benjibst/equilibot/pcb/equilibot.kicad_pcb

## KiCad design pcb/equilibot.kicad_pcb (2025-12-08)

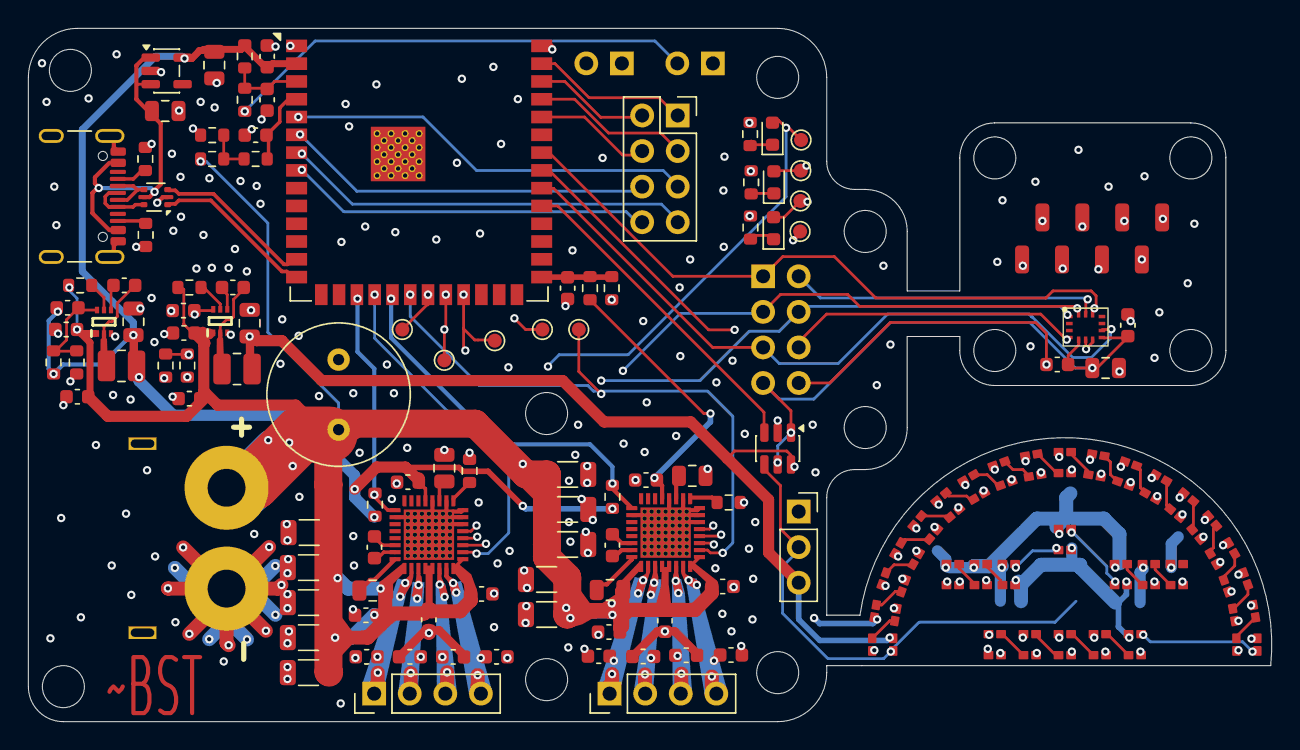
[picture p1: board equilibot.kicad_pcb from above]

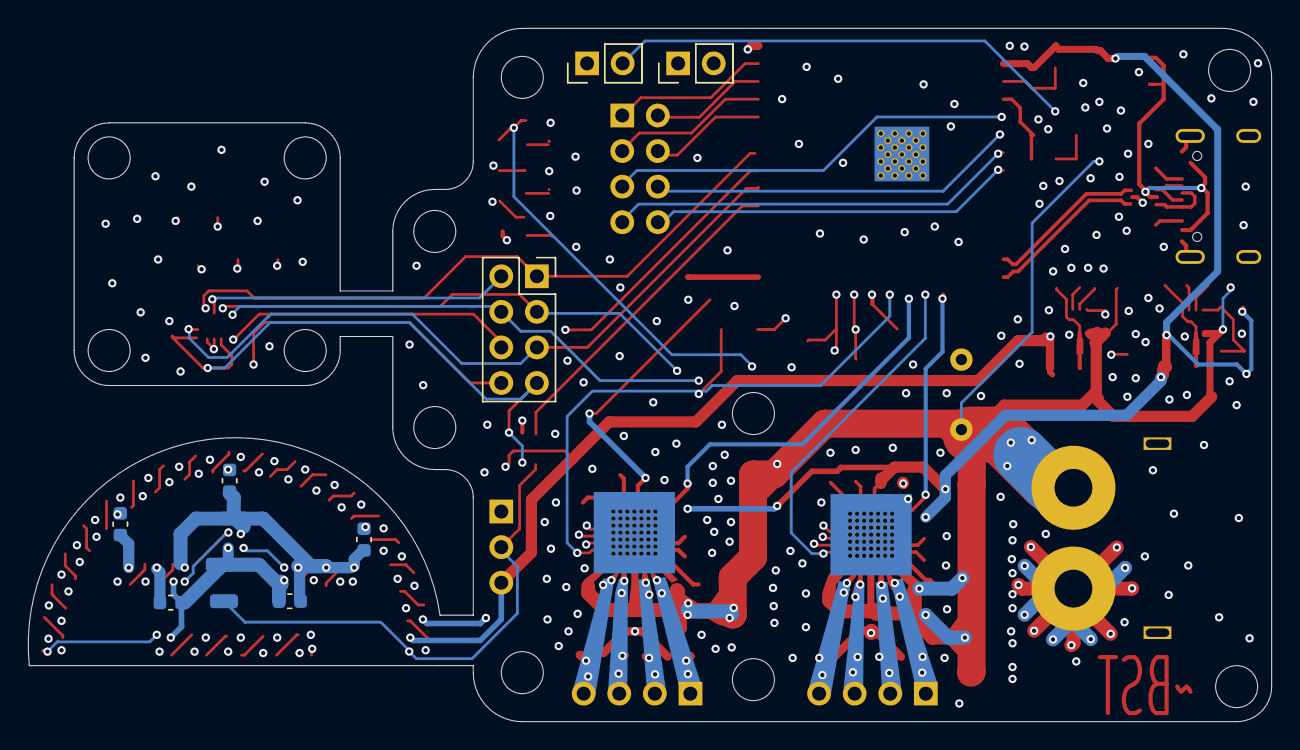
[picture p2: board equilibot.kicad_pcb from below]

Board: 4 copper layers, 88.8 x 49.5 mm, 153 parts (11 on the bottom side), 96 nets.

Parts:
C1, C2, C3, C4, C6, C12, C13, C14, C23, C24, C26, C30, C35, C53, C62, C63: 220n; C_0603_1608Metric
C5, C17, C34, C51, C52: 2.2u; C_0805_2012Metric
C7, C8, C9, C10, C18, C19, C20, C21: 470p; C_0603_1608Metric
C11, C22, C54, C55, C56, C57, C58, C59, C60, C61: 22u; C_1206_3216Metric
C15, C28: 1u; C_0805_2012Metric
C16, C29: 22n; C_0603_1608Metric
C25: 470u; C_Radial_D10.0mm_H16.0mm_P5.00mm
C27, C64: 10u; C_0603_1608Metric
C31, C36: 22u; C_0805_2012Metric
C32, C37, C39, C40, C41, C42, C48: 100n; C_0603_1608Metric
C33, C38: 47p; C_0603_1608Metric
D1, D2, D3, D4, D5, D6, D7, D8, D9, D10, D11, D12, D13, D14, D15, D16, D17, D18, D19, D20, D21, D22, D23, D24, D25, D26, D27, D28, D29, D30, D31: WS2812B; XL_WS2812B_0807
D32, D33, D34: LED_Small; LED_0603_1608Metric
IC1, IC2: TMC5240
IC3, IC4: TPS561243DRLR; SOTFL50P160X60-6N
J1: Conn_01x02_Socket; AMASS_XT60PW-M_1x02_P7.20mm_Horizontal
J2: USB_C_Receptacle_USB2.0_16P; USB_C_Receptacle_GCT_USB4105-xx-A_16P_TopMnt_Horizontal
J3, J4: Conn_01x04_Pin; PinHeader_1x04_P2.54mm_Vertical
J5: Conn_01x03_Pin; PinSocket_1x03_P2.54mm_Vertical
J7, J8: Conn_01x08_Pin; PinSocket_2x04_P2.54mm_Vertical
L1, L2: 3.3u; L_1008_2520Metric
MT1: ICM-42670-P; XDCR_ICM-42670-P
R1, R4: 100; R_0603_1608Metric
R2, R3, R6, R9, R12: 5.6k; R_0603_1608Metric
R5: 12k; R_0603_1608Metric
R7, R11: 3k; R_0603_1608Metric
R8: 10k; R_0603_1608Metric
R10, R16: 13k; R_0603_1608Metric
R13, R17: 100k; R_0603_1608Metric
R14: 135k; R_0603_1608Metric
R15, R19: 30k; R_0603_1608Metric
R18: 220k; R_0603_1608Metric
R20, R21: 5.1k; R_0603_1608Metric
R22: 1k; R_0603_1608Metric
SW1, SW2: SW_Push; PinHeader_1x02_P2.54mm_Vertical
TP1, TP2, TP3, TP4, TP5, TP6, TP7, TP9, TP10: TestPoint; TestPoint_Pad_D1.0mm
TP8, TP11, TP12, TP13, TP14, TP15, TP16, TP17, TP18, TP19, TP20: TestPoint; TestPoint_Pad_1.0x1.0mm
U1: ESP32-S3-WROOM-1
U2: SN74LVC1T45DBV; SOT-23-6
U3: USBLC6-2P6; SOT-666
U4: TLV75533PDBV; SOT-23-5

Connections:
/3V3: C4.2, C5.2, C6.1, C14.2, C26.2, C31.1, C33.2, C52.2, C53.2, D34.2 (A), IC1.5 (VCC_IO), IC2.5 (VCC_IO), J7.7, L1.1, MT1.5 (VDDIO), MT1.8 (VDD), R2.1, R3.1, R9.2, R12.2, R14.2, TP2.1, TP19.1, U1.2 (3V3), U2.1 (VCCA), U2.5 (DIR), U4.5 (OUT)
/5V: C36.1, C38.2, C39.2, C40.2, C41.2, C42.2, C48.2, D1.4 (5V), D2.4 (5V), D3.4 (5V), D4.4 (5V), D5.4 (5V), D6.4 (5V), D7.4 (5V), D8.4 (5V), D9.4 (5V), D10.4 (5V), D11.4 (5V), D12.4 (5V), D13.4 (5V), D14.4 (5V), D15.4 (5V), D16.4 (5V), D17.4 (5V), D18.4 (5V), D19.4 (5V), D20.4 (5V), D21.4 (5V), D22.4 (5V), D23.4 (5V), D24.4 (5V), D25.4 (5V), D26.4 (5V), D27.4 (5V), D28.4 (5V), D29.4 (5V), D30.4 (5V), D31.4 (5V), D33.2 (A), J5.3, L2.1, R18.2, TP3.1, TP11.1, U2.6 (VCCB)
/BAT_MON: C3.2, R6.2, U1.4 (IO4)
/IMU_INT1: J7.6, MT1.4 (INT1/INT), TP18.1, U1.33 (IO40)
/IMU_INT2: J7.5, MT1.9 (INT2), TP17.1, U1.32 (IO39)
/IO5: J8.5, U1.5 (IO5)
/IO6: J8.6, U1.6 (IO6)
/IO7: J8.7, U1.7 (IO7)
/IO15: J8.8, U1.8 (IO15)
/LED_DIN: U1.31 (IO38), U2.3 (A)
/SPI_CS_IMU: J7.1, MT1.12 (AP_CS), TP12.1, U1.34 (IO41)
/SPI_CS_STP1: IC2.26 (CSN/AD2), TP10.1, U1.20 (IO12)
/SPI_CS_STP2: IC1.26 (CSN/AD2), TP9.1, U1.18 (IO10)
/SPI_MISO: IC1.29 (SDO/NAO), IC2.29 (SDO/NAO), J7.4, MT1.1 (AP_SDO/AP_AD0), TP6.1, TP15.1, U1.21 (IO13)
/SPI_MOSI: IC1.28 (SDI/AD0), IC2.28 (SDI/AD0), J7.3, MT1.14 (AP_SDA/AP_SDIO/AP_SDI), TP5.1, TP14.1, U1.22 (IO14)
/SPI_SCLK: IC1.27 (SCK/AD1), IC2.27 (SCK/AD1), J7.2, MT1.13 (AP_SCL/AP_SCLK), TP4.1, TP13.1, U1.23 (IO21)
/STP1_DRV_EN: IC2.9 (DRV_ENN), R12.1, U1.19 (IO11)
/STP2_DRV_EN: IC1.9 (DRV_ENN), R9.1, U1.17 (IO9)
/USB_N: U1.13 (USB_D-), U3.3 (I/O2)
/USB_P: U1.14 (USB_D+), U3.1 (I/O1)
/VM: C11.1, C12.2, C13.2, C15.2, C22.1, C23.2, C24.2, C25.1, C27.1, C28.2, C30.2, C35.2, C54.1, C55.1, C56.1, C57.1, C58.1, C59.1, C60.1, C61.1, C62.2, C63.2, C64.1, D32.2 (A), IC1.17 (VS), IC1.20 (VS), IC1.21 (VS), IC1.24 (VS), IC1.25 (SLEEPN), IC2.17 (VS), IC2.20 (VS), IC2.21 (VS), IC2.24 (VS), IC2.25 (SLEEPN), IC3.1 (VIN), IC4.1 (VIN), J1.2, R5.2, R13.2, R17.2, TP1.1
/leds/DIN_5V: D1.3 (DIN), J5.2, TP16.1, U2.4 (B)
/leds/O1: D12.1 (DOUT), D13.3 (DIN)
/leds/O2: D24.1 (DOUT), D25.3 (DIN)
/psu/SW3V3: C32.2, IC3.4 (BST)
/psu/SW5V: C37.2, IC4.4 (BST)
GND: C1.1, C2.1, C3.1, C4.1, C5.1, C6.2, C7.1, C8.2, C9.1, C10.2, C11.2, C12.1, C13.1, C14.1, C17.2, C18.1, C19.2, C20.1, C21.2, C22.2, C23.1, C24.1, C25.2, C26.1, C27.2, C30.1, C31.2, C34.2, C35.1, C36.2, C39.1, C40.1, C41.1, C42.1, C48.1, C51.1, C52.1, C53.1, C54.2, C55.2, C56.2, C57.2, C58.2, C59.2, C60.2, C61.2, C62.1, C63.1, C64.2, D1.2 (GND), D2.2 (GND), D3.2 (GND), D4.2 (GND), D5.2 (GND), D6.2 (GND), D7.2 (GND), D8.2 (GND), D9.2 (GND), D10.2 (GND), D11.2 (GND), D12.2 (GND), D13.2 (GND), D14.2 (GND), D15.2 (GND), D16.2 (GND), D17.2 (GND), D18.2 (GND), D19.2 (GND), D20.2 (GND), D21.2 (GND), D22.2 (GND), D23.2 (GND), D24.2 (GND), D25.2 (GND), D26.2 (GND), D27.2 (GND), D28.2 (GND), D29.2 (GND), D30.2 (GND), D31.2 (GND), IC1.2 (AIN), IC1.4 (AGND), IC1.10 (UART_EN), IC1.30 (CLK), IC1.31 (REFL), IC1.32 (REFR), IC1.33 (EP), IC2.2 (AIN), IC2.4 (AGND), IC2.10 (UART_EN), IC2.30 (CLK), IC2.31 (REFL), IC2.32 (REFR), IC2.33 (EP), IC3.3 (GND), IC4.3 (GND), J1.1, J2.A1 (GND), J2.A12 (GND), J2.B1 (GND), J2.B12 (GND), J2.S1 (SHIELD), J5.1, J7.8, MT1.6 (GND), MT1.7 (FSYNC), R7.1, R8.2, R10.2, R11.2, R15.1, R16.2, R19.1, R20.1, R21.1, R22.2, SW1.1, SW2.1, TP7.1, TP8.1, TP20.1, U1.1 (GND), U1.40 (GND), U1.41 (EP), U2.2 (GND), U3.2 (GND), U4.2 (GND)
unnamed: D1.1 (DOUT), D2.3 (DIN)
unnamed: D2.1 (DOUT), D3.3 (DIN)
unnamed: D3.1 (DOUT), D4.3 (DIN)
unnamed: D4.1 (DOUT), D5.3 (DIN)
unnamed: D5.1 (DOUT), D6.3 (DIN)
unnamed: D6.1 (DOUT), D7.3 (DIN)
unnamed: D7.1 (DOUT), D8.3 (DIN)
unnamed: D8.1 (DOUT), D9.3 (DIN)
unnamed: D9.1 (DOUT), D10.3 (DIN)
unnamed: D10.1 (DOUT), D11.3 (DIN)
unnamed: D11.1 (DOUT), D12.3 (DIN)
unnamed: D13.1 (DOUT), D14.3 (DIN)
unnamed: D14.1 (DOUT), D15.3 (DIN)
unnamed: D15.1 (DOUT), D16.3 (DIN)
unnamed: D16.1 (DOUT), D17.3 (DIN)
unnamed: D17.1 (DOUT), D18.3 (DIN)
unnamed: D18.1 (DOUT), D19.3 (DIN)
unnamed: D19.1 (DOUT), D20.3 (DIN)
unnamed: D20.1 (DOUT), D21.3 (DIN)
unnamed: D21.1 (DOUT), D22.3 (DIN)
unnamed: D22.1 (DOUT), D23.3 (DIN)
unnamed: D23.1 (DOUT), D24.3 (DIN)
unnamed: D25.1 (DOUT), D26.3 (DIN)
unnamed: D26.1 (DOUT), D27.3 (DIN)
unnamed: D27.1 (DOUT), D28.3 (DIN)
unnamed: D28.1 (DOUT), D29.3 (DIN)
unnamed: D29.1 (DOUT), D30.3 (DIN)
unnamed: D30.1 (DOUT), D31.3 (DIN)
unnamed: D32.1 (K), R8.1
unnamed: D33.1 (K), R11.1
unnamed: D34.1 (K), R22.1
unnamed: C16.1, IC1.14 (CPI)
unnamed: C16.2, IC1.15 (CPO)
unnamed: IC1.1 (IREF), R10.1
unnamed: C7.2, IC1.23 (OUT1A), J3.4
unnamed: C8.1, IC1.18 (OUT1B), J3.1
unnamed: C9.2, IC1.22 (OUT2A), J3.3
unnamed: C10.1, IC1.19 (OUT2B), J3.2
unnamed: C15.1, IC1.16 (VCP)
unnamed: C17.1, IC1.3 (VDD_1V8)
unnamed: C29.1, IC2.14 (CPI)
unnamed: C29.2, IC2.15 (CPO)
unnamed: IC2.1 (IREF), R16.1
unnamed: C18.2, IC2.23 (OUT1A), J4.4
unnamed: C19.1, IC2.18 (OUT1B), J4.1
unnamed: C20.2, IC2.22 (OUT2A), J4.3
unnamed: C21.1, IC2.19 (OUT2B), J4.2
unnamed: C28.1, IC2.16 (VCP)
unnamed: C34.1, IC2.3 (VDD_1V8)
unnamed: IC3.5 (EN), R13.1
unnamed: C33.1, IC3.6 (FB), R14.1, R15.2
unnamed: C32.1, IC3.2 (SW), L1.2
unnamed: IC4.5 (EN), R17.1
unnamed: C38.1, IC4.6 (FB), R18.1, R19.2
unnamed: C37.1, IC4.2 (SW), L2.2
unnamed: J2.A5 (CC1), R20.2
unnamed: J2.B5 (CC2), R21.2
unnamed: J2.A6 (D+), J2.B6 (D+), U3.6 (I/O1)
unnamed: J2.A7 (D-), J2.B7 (D-), U3.4 (I/O2)
unnamed: J8.1, U1.39 (IO1)
unnamed: J8.2, U1.38 (IO2)
unnamed: J8.3, U1.37 (TXD0)
unnamed: J8.4, U1.36 (RXD0)
unnamed: R1.1, SW1.2
unnamed: R4.1, SW2.2
unnamed: R5.1, R6.1, R7.2
unnamed: C1.2, R1.2, R2.2, U1.3 (EN)
unnamed: C2.2, R3.2, R4.2, U1.27 (IO0)
unnamed: C51.2, J2.A4 (VBUS), J2.A9 (VBUS), J2.B4 (VBUS), J2.B9 (VBUS), U3.5 (VBUS), U4.1 (IN), U4.3 (EN)
