benjibst/equilibot/src/main/web_server.cpp

#include "web_server.hpp"

#include "esp_event.h"
#include "esp_log.h"
#include "esp_timer.h"
#include "esp_wifi.h"
#include "nvs.h"
#include "nvs_flash.h"
#include <cmath>
#include <array>
#include <cassert>
#include <cstring>
#include <nlohmann/json.hpp>
#include <type_traits>
#include <utility>
#include "util.hpp"

namespace
{
    constexpr char AP_SSID[] = "equilibot";
    constexpr char AP_PASSWORD[] = "equilibot123";
    constexpr uint8_t WIFI_CHANNEL = 1;
    constexpr uint8_t WIFI_MAX_CONNECTIONS = 4;
    constexpr char kControllerNvsNamespace[] = "controller";
    constexpr char kCascadedPidParamsKey[] = "casc_pid";

    extern const uint8_t index_html_start[] asm("_binary_index_html_start");
    extern const uint8_t index_html_end[] asm("_binary_index_html_end");
    extern const uint8_t motor_html_start[] asm("_binary_motor_html_start");
    extern const uint8_t motor_html_end[] asm("_binary_motor_html_end");
    extern const uint8_t controller_html_start[] asm("_binary_controller_html_start");
    extern const uint8_t controller_html_end[] asm("_binary_controller_html_end");

    bool is_valid_acce_odr(int value)
    {
        return value >= ICM42670_ACCE_ODR_1600HZ && value <= ICM42670_ACCE_ODR_1_5625HZ;
    }

    bool is_valid_gyro_odr(int value)
    {
        return value >= ICM42670_GYRO_ODR_1600HZ && value <= ICM42670_GYRO_ODR_12_5HZ;
    }

    bool is_valid_acce_fs(int value)
    {
        return value >= ICM42670_ACCE_FS_16G && value <= ICM42670_ACCE_FS_2G;
    }

    bool is_valid_gyro_fs(int value)
    {
        return value >= ICM42670_GYRO_FS_2000DPS && value <= ICM42670_GYRO_FS_250DPS;
    }

    bool is_valid_filter_bw(int value)
    {
        return value >= ICM42670_UI_FILT_BW_BYPASS && value <= ICM42670_UI_FILT_BW_16HZ;
    }

    esp_err_t parse_imu_config_json(const nlohmann::json &message,
                                    ICM42670Config &current_config)
    {
        const nlohmann::json &config = message.at("config");

        auto apply_if_valid = [&config, &current_config]<typename TEnum>(const char *key, bool (*valid)(int), TEnum &out)
        {
            int value = config[key];
            if (valid(value))
                out = static_cast<TEnum>(value);
        };

        apply_if_valid("acce_odr", is_valid_acce_odr, current_config.acce_odr);
        apply_if_valid("gyro_odr", is_valid_gyro_odr, current_config.gyro_odr);
        apply_if_valid("acce_fs", is_valid_acce_fs, current_config.acce_fs);
        apply_if_valid("gyro_fs", is_valid_gyro_fs, current_config.gyro_fs);
        apply_if_valid("acce_bw", is_valid_filter_bw, current_config.acce_bw);
        apply_if_valid("gyro_bw", is_valid_filter_bw, current_config.gyro_bw);
        return ESP_OK;
    }

    esp_err_t apply_imu_config_json(ICM42670Spi &imu, ICM42670Config &current_config,
                                    const nlohmann::json &message)
    {
        const esp_err_t parse_err = parse_imu_config_json(message, current_config);
        if (parse_err != ESP_OK)
        {
            return parse_err;
        }

        return imu.configure_sensor(current_config);
    }

    enum class MotorTarget
    {
        Motor1,
        Motor2,
        Both,
    };

    bool parse_motor_target(const nlohmann::json &message, MotorTarget &target)
    {
        const auto it = message.find("motor");
        if (it == message.end() || !it->is_string())
        {
            target = MotorTarget::Both;
            return true;
        }

        const std::string value = it->get<std::string>();
        if (value == "mot1")
        {
            target = MotorTarget::Motor1;
            return true;
        }
        if (value == "mot2")
        {
            target = MotorTarget::Motor2;
            return true;
        }
        if (value == "both")
        {
            target = MotorTarget::Both;
            return true;
        }
        return false;
    }

    bool json_number_to_float(const nlohmann::json &object, const char *key, float &out)
    {
        const auto it = object.find(key);
        if (it == object.end() || !it->is_number())
        {
            return false;
        }

        const double value = it->get<double>();
        if (!std::isfinite(value))
        {
            return false;
        }

        out = static_cast<float>(value);
        return true;
    }

    bool parse_pid_gains_json(const nlohmann::json &object, PidGains &gains)
    {
        return json_number_to_float(object, "kp", gains.kp) &&
               json_number_to_float(object, "ki", gains.ki) &&
               json_number_to_float(object, "kd", gains.kd);
    }

    bool is_valid_pid_gains(const PidGains &gains)
    {
        return std::isfinite(gains.kp) &&
               std::isfinite(gains.ki) &&
               std::isfinite(gains.kd);
    }

    bool is_valid_cascaded_pid_parameters(const CascadedPidParameters &parameters)
    {
        return is_valid_pid_gains(parameters.position) &&
               is_valid_pid_gains(parameters.pitch);
    }

    esp_err_t parse_cascaded_pid_parameters_json(const nlohmann::json &message,
                                                 CascadedPidParameters &parameters)
    {
        const auto config_it = message.find("config");
        if (config_it == message.end() || !config_it->is_object())
        {
            return ESP_ERR_INVALID_ARG;
        }

        const auto &config = *config_it;
        const auto position_it = config.find("position");
        const auto pitch_it = config.find("pitch");
        if (position_it == config.end() || !position_it->is_object() ||
            pitch_it == config.end() || !pitch_it->is_object())
        {
            return ESP_ERR_INVALID_ARG;
        }

        if (!parse_pid_gains_json(*position_it, parameters.position) ||
            !parse_pid_gains_json(*pitch_it, parameters.pitch))
        {
            return ESP_ERR_INVALID_ARG;
        }

        return ESP_OK;
    }

    esp_err_t load_cascaded_pid_parameters_from_nvs(CascadedPidParameters &parameters)
    {
        static_assert(std::is_trivially_copyable_v<CascadedPidParameters>);

        nvs_handle_t handle = 0;
        esp_err_t err = nvs_open(kControllerNvsNamespace, NVS_READONLY, &handle);
        if (err != ESP_OK)
        {
            return err;
        }

        CascadedPidParameters loaded = {};
        size_t loaded_size = sizeof(loaded);
        err = nvs_get_blob(handle, kCascadedPidParamsKey, &loaded, &loaded_size);
        nvs_close(handle);
        if (err != ESP_OK)
        {
            return err;
        }

        if (loaded_size != sizeof(loaded))
        {
            return ESP_ERR_NVS_INVALID_LENGTH;
        }

        if (!is_valid_cascaded_pid_parameters(loaded))
        {
            return ESP_ERR_INVALID_STATE;
        }

        parameters = loaded;
        return ESP_OK;
    }

    esp_err_t save_cascaded_pid_parameters_to_nvs(const CascadedPidParameters &parameters)
    {
        static_assert(std::is_trivially_copyable_v<CascadedPidParameters>);

        if (!is_valid_cascaded_pid_parameters(parameters))
        {
            return ESP_ERR_INVALID_ARG;
        }

        nvs_handle_t handle = 0;
        esp_err_t err = nvs_open(kControllerNvsNamespace, NVS_READWRITE, &handle);
        if (err != ESP_OK)
        {
            return err;
        }

        err = nvs_set_blob(handle, kCascadedPidParamsKey, &parameters, sizeof(parameters));
        if (err == ESP_OK)
        {
            err = nvs_commit(handle);
        }
        nvs_close(handle);
        return err;
    }
} // namespace

WebServer::WebServer(ICM42670Spi &imu,
                     const ICM42670Config &imu_config,
                     TMC5240 &motor1,
                     TMC5240 &motor2,
                     CascadedPidController &controller)
    : imu_(imu), imu_config_(imu_config), motor1_(motor1), motor2_(motor2), controller_(controller)
{
    auto web_server_err = start();
    if (web_server_err != ESP_OK)
    {
        LOG_E("Failed to start web server: %s", esp_err_to_name(web_server_err));
    }
}

esp_err_t WebServer::start()
{
    if (started_)
    {
        return ESP_OK;
    }

    esp_err_t err = init_nvs();
    if (err != ESP_OK)
    {
        return err;
    }

    CascadedPidParameters persisted_parameters = {};
    const esp_err_t load_pid_err = load_cascaded_pid_parameters_from_nvs(persisted_parameters);
    if (load_pid_err == ESP_OK)
    {
        controller_.set_parameters(persisted_parameters);
        LOG_I("Loaded cascaded PID config from NVS");
    }
    else if (load_pid_err != ESP_ERR_NVS_NOT_FOUND)
    {
        LOG_W("Failed loading cascaded PID config from NVS: %s", esp_err_to_name(load_pid_err));
    }

    err = init_softap();
    if (err != ESP_OK)
    {
        return err;
    }

    httpd_config_t config = HTTPD_DEFAULT_CONFIG();
    config.stack_size = 4096 + 2048;
    err = httpd_start(&server_, &config);
    if (err != ESP_OK)
    {
        return err;
    }
    assert(server_ != nullptr);

    const httpd_uri_t root_uri = {
        .uri = "/",
        .method = HTTP_GET,
        .handler = root_get_handler,
        .user_ctx = this,
        .is_websocket = false,
        .handle_ws_control_frames = false,
        .supported_subprotocol = nullptr,
    };
    err = httpd_register_uri_handler(server_, &root_uri);
    if (err != ESP_OK)
    {
        httpd_stop(server_);
        server_ = nullptr;
        return err;
    }

    const httpd_uri_t motor_uri = {
        .uri = "/motor",
        .method = HTTP_GET,
        .handler = motor_get_handler,
        .user_ctx = this,
        .is_websocket = false,
        .handle_ws_control_frames = false,
        .supported_subprotocol = nullptr,
    };
    err = httpd_register_uri_handler(server_, &motor_uri);
    if (err != ESP_OK)
    {
        httpd_stop(server_);
        server_ = nullptr;
        return err;
    }

    const httpd_uri_t controller_uri = {
        .uri = "/controller",
        .method = HTTP_GET,
        .handler = controller_get_handler,
        .user_ctx = this,
        .is_websocket = false,
        .handle_ws_control_frames = false,
        .supported_subprotocol = nullptr,
    };
    err = httpd_register_uri_handler(server_, &controller_uri);
    if (err != ESP_OK)
    {
        httpd_stop(server_);
        server_ = nullptr;
        return err;
    }

    const httpd_uri_t ws_uri = {
        .uri = "/ws",
        .method = HTTP_GET,
        .handler = ws_get_handler,
        .user_ctx = this,
        .is_websocket = true,
        .handle_ws_control_frames = false,
        .supported_subprotocol = nullptr,
    };
    err = httpd_register_uri_handler(server_, &ws_uri);
    if (err != ESP_OK)
    {
        httpd_stop(server_);
        server_ = nullptr;
        return err;
    }

    const BaseType_t task_create_result = telemetry_sender_task_.create("web_tx",
                                                                        tskIDLE_PRIORITY + 2,
                                                                        telemetry_sender_task_entry,
                                                                        *this);
    assert(task_create_result == pdPASS);
    if (task_create_result != pdPASS)
    {
        httpd_stop(server_);
        server_ = nullptr;
        return ESP_ERR_NO_MEM;
    }

    started_ = true;
    LOG_I("SoftAP started. Open http://192.168.4.1/");
    return ESP_OK;
}

esp_err_t WebServer::queue_imu_data(const TelemetryData &sample)
{
    return telemetry_queue_.send(sample, 0) == pdPASS ? ESP_OK : ESP_FAIL;
}

esp_err_t WebServer::root_get_handler(httpd_req_t *request)
{
    httpd_resp_set_type(request, "text/html; charset=utf-8");
    const size_t html_len = static_cast<size_t>(index_html_end - index_html_start);
    return httpd_resp_send(request, reinterpret_cast<const char *>(index_html_start), html_len);
}

esp_err_t WebServer::motor_get_handler(httpd_req_t *request)
{
    httpd_resp_set_type(request, "text/html; charset=utf-8");
    const size_t html_len = static_cast<size_t>(motor_html_end - motor_html_start);
    return httpd_resp_send(request, reinterpret_cast<const char *>(motor_html_start), html_len);
}

esp_err_t WebServer::controller_get_handler(httpd_req_t *request)
{
    httpd_resp_set_type(request, "text/html; charset=utf-8");
    const size_t html_len = static_cast<size_t>(controller_html_end - controller_html_start);
    return httpd_resp_send(request, reinterpret_cast<const char *>(controller_html_start), html_len);
}

esp_err_t WebServer::ws_get_handler(httpd_req_t *request)
{
    WebServer &server = *static_cast<WebServer *>(request->user_ctx);
    return server.handle_ws_request(request);
}

esp_err_t WebServer::handle_ws_request(httpd_req_t *request)
{
    if (request->method == HTTP_GET)
    {
        LOG_I("WebSocket handshake complete");
        return ESP_OK;
    }

    httpd_ws_frame_t ws_frame = {};
    esp_err_t err = httpd_ws_recv_frame(request, &ws_frame, 0);
    if (err != ESP_OK)
    {
        LOG_W("ws recv length failed: %s", esp_err_to_name(err));
        return err;
    }

    if (ws_frame.len == 0)
    {
        return ESP_OK;
    }

    std::string payload(ws_frame.len, '\0');
    ws_frame.payload = reinterpret_cast<uint8_t *>(payload.data());
    err = httpd_ws_recv_frame(request, &ws_frame, ws_frame.len);
    if (err != ESP_OK)
    {
        return err;
    }

    const char *begin = payload.data();
    const char *end = begin + ws_frame.len;
    const nlohmann::json message = nlohmann::json::parse(begin, end, nullptr, false);
    if (message.is_discarded())
    {
        LOG_W("Invalid websocket JSON payload");
        return ESP_OK;
    }

    const auto type_it = message.find("type");
    if (type_it != message.end() && type_it->is_string() && type_it->get<std::string>() == "imu_config")
    {
        const esp_err_t apply_err = apply_imu_config_json(imu_, imu_config_, message);
        if (apply_err != ESP_OK)
        {
            LOG_W("Failed applying IMU config: %s", esp_err_to_name(apply_err));
        }
        else
        {
            LOG_I("Applied IMU config over websocket");
        }
    }
    else if (type_it != message.end() && type_it->is_string() && type_it->get<std::string>() == "motor_velocity")
    {
        MotorTarget target = MotorTarget::Both;
        if (!parse_motor_target(message, target))
        {
            LOG_W("Invalid motor target in motor_velocity command");
            return ESP_OK;
        }

        const auto velocity_it = message.find("velocity");
        if (velocity_it == message.end() || !velocity_it->is_number_integer())
        {
            LOG_W("Invalid velocity payload");
            return ESP_OK;
        }
        const int32_t velocity = velocity_it->get<int32_t>();

        if (target == MotorTarget::Motor1 || target == MotorTarget::Both)
        {
            const esp_err_t err_set = motor1_.set_velocity(velocity);
            if (err_set != ESP_OK)
            {
                LOG_W("Failed setting motor1 velocity: %s", esp_err_to_name(err_set));
            }
        }
        if (target == MotorTarget::Motor2 || target == MotorTarget::Both)
        {
            const esp_err_t err_set = motor2_.set_velocity(velocity);
            if (err_set != ESP_OK)
            {
                LOG_W("Failed setting motor2 velocity: %s", esp_err_to_name(err_set));
            }
        }
    }
    else if (type_it != message.end() && type_it->is_string() && type_it->get<std::string>() == "spreadcycle_config")
    {
        MotorTarget target = MotorTarget::Both;
        if (!parse_motor_target(message, target))
        {
            LOG_W("Invalid motor target in spreadcycle_config command");
            return ESP_OK;
        }

        const auto config_it = message.find("config");
        if (config_it == message.end() || !config_it->is_object())
        {
            LOG_W("Missing config object in spreadcycle_config command");
            return ESP_OK;
        }

        const auto &config = *config_it;
        if (!config.contains("toff") || !config.contains("tbl") ||
            !config.contains("hstart") ||
            !config.contains("hend"))
        {
            LOG_W("Incomplete spreadcycle_config payload");
            return ESP_OK;
        }

        const bool type_ok =
            config["toff"].is_number_integer() &&
            config["tbl"].is_number_integer() &&
            config["hstart"].is_number_integer() &&
            config["hend"].is_number_integer();
        if (!type_ok)
        {
            LOG_W("Invalid type in spreadcycle_config payload");
            return ESP_OK;
        }

        const uint8_t toff = static_cast<uint8_t>(config["toff"].get<int>());
        const uint8_t tbl = static_cast<uint8_t>(config["tbl"].get<int>());
        const uint8_t hstart = static_cast<uint8_t>(config["hstart"].get<int>());
        const uint8_t hend = static_cast<uint8_t>(config["hend"].get<int>());
        const char *target_str = (target == MotorTarget::Motor1) ? "mot1" : (target == MotorTarget::Motor2) ? "mot2"
                                                                                                            : "both";
        LOG_I(
            "Applying spreadcycle config to %s: TOFF=%u TBL=%u HSTART=%u HEND=%u",
            target_str,
            static_cast<unsigned>(toff),
            static_cast<unsigned>(tbl),
            static_cast<unsigned>(hstart),
            static_cast<unsigned>(hend));

        if (target == MotorTarget::Motor1 || target == MotorTarget::Both)
        {
            const esp_err_t err_set = motor1_.set_spreadcycle_config(toff, tbl, hstart, hend);
            if (err_set != ESP_OK)
            {
                LOG_W("Failed setting motor1 spreadcycle config: %s", esp_err_to_name(err_set));
            }
        }
        if (target == MotorTarget::Motor2 || target == MotorTarget::Both)
        {
            const esp_err_t err_set = motor2_.set_spreadcycle_config(toff, tbl, hstart, hend);
            if (err_set != ESP_OK)
            {
                LOG_W("Failed setting motor2 spreadcycle config: %s", esp_err_to_name(err_set));
            }
        }
    }
    else if (type_it != message.end() && type_it->is_string() &&
             type_it->get<std::string>() == "cascaded_pid_config")
    {
        CascadedPidParameters parameters = {};
        const esp_err_t parse_err = parse_cascaded_pid_parameters_json(message, parameters);
        if (parse_err != ESP_OK)
        {
            LOG_W("Invalid cascaded_pid_config payload");
            return ESP_OK;
        }

        controller_.set_parameters(parameters);
        const esp_err_t save_err = save_cascaded_pid_parameters_to_nvs(parameters);
        if (save_err != ESP_OK)
        {
            LOG_W("Applied cascaded PID config over websocket but failed saving to NVS: %s",
                  esp_err_to_name(save_err));
        }
        else
        {
            LOG_I("Applied cascaded PID config over websocket and saved to NVS");
        }
    }

    return ESP_OK;
}

void WebServer::ws_broadcast_work(void *arg)
{
    WsBroadcastContext *context = static_cast<WsBroadcastContext *>(arg);
    auto finish = [context]()
    {
        context->server->pending_ws_broadcasts_.fetch_sub(1, std::memory_order_release);
        delete context;
    };

    std::array<int, CONFIG_LWIP_MAX_SOCKETS> client_fds = {};
    size_t fd_count = client_fds.size();
    esp_err_t list_err = httpd_get_client_list(context->server->server_, &fd_count, client_fds.data());
    if (list_err != ESP_OK)
    {
        LOG_W("httpd_get_client_list failed: %s", esp_err_to_name(list_err));
        finish();
        return;
    }

    httpd_ws_frame_t ws_frame = {};
    ws_frame.type = HTTPD_WS_TYPE_TEXT;
    ws_frame.payload = reinterpret_cast<uint8_t *>(context->payload.data());
    ws_frame.len = context->payload.size();

    for (size_t i = 0; i < fd_count; ++i)
    {
        const int fd = client_fds[i];
        if (httpd_ws_get_fd_info(context->server->server_, fd) != HTTPD_WS_CLIENT_WEBSOCKET)
        {
            continue;
        }

        const esp_err_t send_err = httpd_ws_send_frame_async(context->server->server_, fd, &ws_frame);
        if (send_err != ESP_OK)
        {
            LOG_W("ws send failed on fd=%d: %s", fd, esp_err_to_name(send_err));
        }
    }
    finish();
}

void WebServer::telemetry_sender_task_entry(WebServer &self)
{
    self.telemetry_sender_task();
}

void WebServer::telemetry_sender_task()
{
    int64_t last_publish_ts_us = 0;
    while (true)
    {
        TelemetryData telemetry = {};
        if (telemetry_queue_.receive(telemetry, portMAX_DELAY) != pdTRUE)
        {
            continue;
        }

        // Keep only latest samples while no WS client is connected.
        if (websocket_client_count() == 0)
        {
            while (telemetry_queue_.receive(telemetry, 0) == pdTRUE)
            {
            }
            continue;
        }

        // Bound heap growth by dropping frames while older broadcasts are still pending.
        if (pending_ws_broadcasts_.load(std::memory_order_acquire) >= kMaxPendingWsBroadcasts)
        {
            while (telemetry_queue_.receive(telemetry, 0) == pdTRUE)
            {
            }
            continue;
        }

        const int64_t now_us = esp_timer_get_time();
        if ((now_us - last_publish_ts_us) < kTelemetryMinPublishIntervalUs)
        {
            while (telemetry_queue_.receive(telemetry, 0) == pdTRUE)
            {
            }
            continue;
        }

        nlohmann::json payload = {
            {"acc", nlohmann::json::array()},
            {"gyro", nlohmann::json::array()},
        };
        payload["acc"].get_ref<nlohmann::json::array_t &>().reserve(kMaxSamplesPerTelemetryPayload);
        payload["gyro"].get_ref<nlohmann::json::array_t &>().reserve(kMaxSamplesPerTelemetryPayload);

        auto append_sample = [&payload](const ICM42670Sample &telemetry_sample)
        {
            const std::array<float, 3> acc_data = {
                telemetry_sample.acc[0],
                telemetry_sample.acc[1],
                telemetry_sample.acc[2],
            };
            const std::array<float, 3> gyro_data = {
                telemetry_sample.gyro[0],
                telemetry_sample.gyro[1],
                telemetry_sample.gyro[2],
            };
            payload["acc"].push_back({
                {"ts_us", telemetry_sample.ts_us},
                {"data", acc_data},
            });
            payload["gyro"].push_back({
                {"ts_us", telemetry_sample.ts_us},
                {"data", gyro_data},
            });
        };

        append_sample(telemetry.sample);
        size_t samples_in_payload = 1;
        while (samples_in_payload < kMaxSamplesPerTelemetryPayload &&
               telemetry_queue_.receive(telemetry, 0) == pdTRUE)
        {
            append_sample(telemetry.sample);
            ++samples_in_payload;
        }
        payload["simple_rot"] = telemetry.orientation._vec;
        payload["controller"] = {
            {"type", "cascaded_pid"},
            {"target_position", telemetry.controller.target_position},
            {"position", telemetry.controller.position},
            {"velocity", telemetry.controller.velocity},
            {"pitch_deg", telemetry.controller.pitch_deg},
            {"pitch_rate_deg_s", telemetry.controller.pitch_rate_deg_s},
            {"target_pitch_deg", telemetry.controller.target_pitch_deg},
            {"velocity_command", telemetry.controller.velocity_command},
            {"parameters",
             {
                 {"position",
                  {
                      {"kp", telemetry.controller.parameters.position.kp},
                      {"ki", telemetry.controller.parameters.position.ki},
                      {"kd", telemetry.controller.parameters.position.kd},
                  }},
                 {"pitch",
                  {
                      {"kp", telemetry.controller.parameters.pitch.kp},
                      {"ki", telemetry.controller.parameters.pitch.ki},
                      {"kd", telemetry.controller.parameters.pitch.kd},
                  }},
             }},
        };
        std::string serialized = payload.dump();
        if (publish_telemetry_payload(std::move(serialized)) == ESP_OK)
        {
            last_publish_ts_us = now_us;
        }
    }
}

esp_err_t WebServer::publish_telemetry_payload(std::string &&serialized)
{
    const size_t prev_pending = pending_ws_broadcasts_.fetch_add(1, std::memory_order_acq_rel);
    if (prev_pending >= kMaxPendingWsBroadcasts)
    {
        pending_ws_broadcasts_.fetch_sub(1, std::memory_order_release);
        return ESP_ERR_NO_MEM;
    }

    auto *context = new WsBroadcastContext{
        .server = this,
        .payload = std::move(serialized),
    };
    if (context == nullptr)
    {
        pending_ws_broadcasts_.fetch_sub(1, std::memory_order_release);
        return ESP_ERR_NO_MEM;
    }

    const esp_err_t err = httpd_queue_work(server_, ws_broadcast_work, context);
    if (err != ESP_OK)
    {
        pending_ws_broadcasts_.fetch_sub(1, std::memory_order_release);
        delete context;
    }
    return err;
}

size_t WebServer::websocket_client_count() const
{
    if (server_ == nullptr)
    {
        return 0;
    }

    std::array<int, CONFIG_LWIP_MAX_SOCKETS> client_fds = {};
    size_t fd_count = client_fds.size();
    if (httpd_get_client_list(server_, &fd_count, client_fds.data()) != ESP_OK)
    {
        return 0;
    }

    size_t ws_count = 0;
    for (size_t i = 0; i < fd_count; ++i)
    {
        if (httpd_ws_get_fd_info(server_, client_fds[i]) == HTTPD_WS_CLIENT_WEBSOCKET)
        {
            ++ws_count;
        }
    }
    return ws_count;
}

esp_err_t WebServer::init_nvs()
{
    esp_err_t err = nvs_flash_init();
    if (err == ESP_ERR_NVS_NO_FREE_PAGES || err == ESP_ERR_NVS_NEW_VERSION_FOUND)
    {
        err = nvs_flash_erase();
        if (err != ESP_OK)
        {
            return err;
        }
        err = nvs_flash_init();
    }
    return err;
}

esp_err_t WebServer::init_softap()
{
    esp_err_t err = esp_netif_init();
    if (err != ESP_OK && err != ESP_ERR_INVALID_STATE)
    {
        return err;
    }

    err = esp_event_loop_create_default();
    if (err != ESP_OK && err != ESP_ERR_INVALID_STATE)
    {
        return err;
    }

    ap_netif_ = esp_netif_create_default_wifi_ap();
    assert(ap_netif_ != nullptr);

    wifi_init_config_t init_cfg = WIFI_INIT_CONFIG_DEFAULT();
    err = esp_wifi_init(&init_cfg);
    if (err != ESP_OK)
    {
        return err;
    }

    wifi_config_t ap_cfg = {};
    std::strncpy(reinterpret_cast<char *>(ap_cfg.ap.ssid), AP_SSID, sizeof(ap_cfg.ap.ssid));
    std::strncpy(reinterpret_cast<char *>(ap_cfg.ap.password), AP_PASSWORD, sizeof(ap_cfg.ap.password));
    ap_cfg.ap.ssid_len = std::strlen(AP_SSID);
    ap_cfg.ap.channel = WIFI_CHANNEL;
    ap_cfg.ap.max_connection = WIFI_MAX_CONNECTIONS;
    ap_cfg.ap.authmode = WIFI_AUTH_WPA2_PSK;

    err = esp_wifi_set_mode(WIFI_MODE_AP);
    if (err != ESP_OK)
    {
        return err;
    }

    err = esp_wifi_set_config(WIFI_IF_AP, &ap_cfg);
    if (err != ESP_OK)
    {
        return err;
    }

    return esp_wifi_start();
}
