benjibst/equilibot/src/main/web_server.hpp

#pragma once

#include "cascaded_pid_controller.hpp"
#include "esp_err.h"
#include "esp_http_server.h"
#include "esp_netif.h"
#include "freertos_wrappers.hpp"
#include "icm42670_spi.hpp"
#include "tmc5240.hpp"
#include "vectors.hpp"
#include <atomic>
#include <cstddef>
#include <cstdint>
#include <string>

class WebServer
{
public:
    struct TelemetryData
    {
        ICM42670Sample sample;
        Quaternion orientation;
        CascadedPidSnapshot controller;
    };
    WebServer(ICM42670Spi &imu,
              const ICM42670Config &imu_config,
              TMC5240 &motor1,
              TMC5240 &motor2,
              CascadedPidController &controller);

    esp_err_t start();
    esp_err_t queue_imu_data(const TelemetryData &sample);

    WebServer(const WebServer &) = delete;
    WebServer &operator=(const WebServer &) = delete;
    WebServer(WebServer &&) = delete;
    WebServer &operator=(WebServer &&) = delete;

private:
    static constexpr size_t kTelemetryQueueLength = 8;
    static constexpr size_t kMaxSamplesPerTelemetryPayload = kTelemetryQueueLength;
    static constexpr uint32_t kTelemetryTaskStackSizeBytes = 4096;
    static constexpr size_t kMaxPendingWsBroadcasts = 2;
    static constexpr int64_t kTelemetryMinPublishIntervalUs = 20'000; // 50 Hz cap

    struct WsBroadcastContext
    {
        WebServer *server;
        std::string payload;
    };

    static esp_err_t root_get_handler(httpd_req_t *request);
    static esp_err_t motor_get_handler(httpd_req_t *request);
    static esp_err_t controller_get_handler(httpd_req_t *request);
    static esp_err_t ws_get_handler(httpd_req_t *request);
    static void ws_broadcast_work(void *arg);
    static void telemetry_sender_task_entry(WebServer &self);

    esp_err_t init_nvs();
    esp_err_t init_softap();
    esp_err_t handle_ws_request(httpd_req_t *request);
    esp_err_t publish_telemetry_payload(std::string &&serialized);
    void telemetry_sender_task();
    size_t websocket_client_count() const;

    ICM42670Spi &imu_;
    ICM42670Config imu_config_;
    TMC5240 &motor1_;
    TMC5240 &motor2_;
    CascadedPidController &controller_;

    httpd_handle_t server_ = nullptr;
    esp_netif_t *ap_netif_ = nullptr;
    bool started_ = false;
    std::atomic<size_t> pending_ws_broadcasts_{0};

    StaticQueue<TelemetryData, kTelemetryQueueLength> telemetry_queue_;
    StaticTask<kTelemetryTaskStackSizeBytes, WebServer> telemetry_sender_task_;
};
