benjibst/equilibot/src/main/util.hpp

#pragma once
#define LOG_E(...) ESP_LOGE(__FILE__, __VA_ARGS__)
#define LOG_W(...) ESP_LOGW(__FILE__, __VA_ARGS__)
#define LOG_I(...) ESP_LOGI(__FILE__, __VA_ARGS__)
#define LOG_D(...) ESP_LOGD(__FILE__, __VA_ARGS__)
