benjibst/equilibot/(commit log)

2025-11-29 driver and buck converter layout
    [BLDC_driver.kicad_sch, equilibot.kicad_pcb, imu.kicad_sch, leds.kicad_sch, psu.kicad_sch, stepper_driver.kicad_sch]
2025-12-02 add jlcpcb part numbers
    [bom.csv, designators.csv, equilibot.kicad_pcb, imu.kicad_sch, leds.kicad_sch, positions.csv, psu.kicad_sch, stepper_driver.kicad_sch]
2025-12-04 remove esp32 module from production
    [equilibot.kicad_pcb]
2025-12-05 change layout of extern led board to not show vias
    [equilibot.kicad_pcb, export_cart_20251206_003402.csv, imu.kicad_sch, psu.kicad_sch]
2026-02-14 abstraction for adressable leds
2026-02-14 add fork of esp bsp for spi communication with icm42670
2026-02-14 led strip example in separate file
2026-02-18 initial tmc5240 driver
2026-02-19 filtered data
2026-02-20 Add ICM42670 data-ready interrupt task and sample queue pipeline
2026-02-20 Revert batched websocket payloads; stream queued telemetry sample-by-sample
    [main.cpp, web_server.cpp, web_server.hpp]
2026-02-21 imu configuration via web interface
2026-03-01 kalman filter
2026-03-01 show tilt on leds
2026-03-29 pid controller for angle, not working yet
    [battery_monitor.cpp, battery_monitor.hpp, icm42670_spi.cpp, icm42670_spi.hpp, led_strip.cpp, main.cpp, pid_controller.hpp, spi_bus.cpp]
2026-04-02 casaded pid controller
